IlhamIbrahimli/Archimedes-Keyboard-Emu/(commit log)

2025-04-15 Arduino program + extras
    Service manual, same program in PIC asm for A5000 (doesn't work on A310) - Not mine I found it on forum, was a good aid and Service manual attached listing all info about the keyboard protocol along with schematic
2025-04-21 Made RQMP actually accessible, made it so mouse movement is recieved before sending, capped mouse button sending to 3 mouse buttons so it doesnt do an infinite loop or error out
2025-04-21 Made it so the code empties the leftover scancodes after a printscreen key
